Alberto0235/LLC-GaN-Microinverter/Simulations/Efficiency_Sweep/Full 100W 100KHz.asc

A1: diffschmitt; vhigh=5 vlow=0 vt={vt}; trise=10n tfall=10n
A2: diffschmitt; vhigh=5 vlow=0 vt={vt}; trise=10n tfall=10n
A3: diffschmitt; vhigh=5 vlow=0 vt={vt}; trise=10n tfall=10n
A4: diffschmitt; vhigh=5 vlow=0 vt={vt}; trise=10n tfall=10n
C1: cap; 40µ
C2: cap; 10µ; Rser=1n
Cr: cap; 3.4µ
L1: ind2; 297m
L2: ind2; 1m
L3: ind; 120µ; Rser=1n
Lm: ind; 3.93µ
LOAD: res; 565
Lr: ind; 743n
TA1: GaN_LTspice_GS-065-004-1-L_L1V3P1
TA2: GaN_LTspice_GS-065-004-1-L_L1V3P1
TB1: GaN_LTspice_GS-065-004-1-L_L1V3P1
TB2: GaN_LTspice_GS-065-004-1-L_L1V3P1
U1: EPCGaN; EPC2207
U2: EPCGaN; EPC2207
U3: EPCGaN; EPC2207
U4: EPCGaN; EPC2207
U5: GaN_LTspice_GS-065-004-1-L_L1V3P1
U6: GaN_LTspice_GS-065-004-1-L_L1V3P1
U7: GaN_LTspice_GS-065-004-1-L_L1V3P1
U8: GaN_LTspice_GS-065-004-1-L_L1V3P1
V1: voltage; 24
V2: voltage; PULSE(0 5 0 4n 4n {1/(2*f)} {1/f})
V3: voltage; PULSE(0 5 {(1/(2*f))+2*td} 4n 4n {(1/(2*f))-4*td} {1/f})
V4: voltage; PULSE(0 5 {(1/(2*f))+2*td} 4n 4n {(1/(2*f))-4*td} {1/f})
V5: voltage; PULSE(0 5 0 4n 4n {1/(2*f)} {1/f})
V6: voltage; PULSE(0 5 0 4n 4n {1/(2*f)} {1/f})
V7: voltage; PULSE(0 5 {(1/(2*f))+2*td} 4n 4n {(1/(2*f))-4*td} {1/f})
V8: voltage; PULSE(0 5 {(1/(2*f))+2*td} 4n 4n {(1/(2*f))-4*td} {1/f})
V9: voltage; PULSE(0 5 0 4n 4n {1/(2*f)} {1/f})
V10: voltage; PULSE({-v_tri} {v_tri} 0 {1/(2*f_tri)} {1/(2*f_tri)} 0 {1/f_tri})
V11: voltage; SINE(0 {V_control} {f_sin})
V12: voltage; PULSE({-v_tri} {v_tri} 0 {1/(2*f_tri)} {1/(2*f_tri)} 0 {1/f_tri})
V13: voltage; SINE(0 {V_control} {f_sin} 0 0 180)
V15: voltage; PULSE({-v_tri} {v_tri} 0 {1/(2*f_tri)} {1/(2*f_tri)} 0 {1/f_tri})
V16: voltage; SINE(0 {V_control} {f_sin})
V17: voltage; PULSE({-v_tri} {v_tri} 0 {1/(2*f_tri)} {1/(2*f_tri)} 0 {1/f_tri})
V18: voltage; SINE(0 {V_control} {f_sin} 0 0 180)
Named nets: G1, G2, G3, G4, S1, S2, S, 0, VOUT, VIN, G5, G6, G7, G8, S5, S6, VC1+, VC1-, VC2+, VC2-, VC1\+, VC2\+, VOUT2, VOUT1
K L1 L2 1
.tran 40.01m
.param f=100k td=4n
.meas Pin AVG V(VIN)*-I(V1) FROM 20m TO 40m
.meas Pout AVG V(VOUT1,VOUT2)*-I(LOAD) FROM 20m TO 40m
.meas Eff param Pout/Pin
.meas Vin AVG V(VIN) FROM 20m TO 40m
.meas Iin AVG -I(V1) FROM 20m TO 40m
.meas Vout RMS V(VOUT1,VOUT2) FROM 20m TO 40m
.meas Iout RMS I(LOAD) FROM 20m TO 40m
.lib EPCGaNLibrary.lib
.param v_control=4.201 v_tri=5 vt=0.02 f_tri=100k f_sin=50
.param Vin=325 I_in=0.31 eff=0.98
