Alberto0235/LLC-GaN-Microinverter/Simulations/Device_Comparison/Circuit 400W V1 100KHz - GAN080-650EBE_LTspice.asc

C1: cap; 10µ
Cr: cap; 3.4µ
L1: ind2; 297m
L2: ind2; 1m
Lm: ind; 3.93µ
LOAD: res; 400
Lr: ind; 743n
U1: EPCGaN; EPC2207
U2: EPCGaN; EPC2207
U3: EPCGaN; EPC2207
U4: EPCGaN; EPC2207
U5: GAN080-650EBE
U6: GAN080-650EBE
U7: GAN080-650EBE
U9: GAN080-650EBE
V1: voltage; 24
V2: voltage; PULSE(0 5 0 4n 4n {1/(2*f)} {1/f})
V3: voltage; PULSE(0 5 {(1/(2*f))+2*td} 4n 4n {(1/(2*f))-4*td} {1/f})
V4: voltage; PULSE(0 5 {(1/(2*f))+2*td} 4n 4n {(1/(2*f))-4*td} {1/f})
V5: voltage; PULSE(0 5 0 4n 4n {1/(2*f)} {1/f})
V6: voltage; PULSE(0 5 0 4n 4n {1/(2*f)} {1/f})
V7: voltage; PULSE(0 5 {(1/(2*f))+2*td} 4n 4n {(1/(2*f))-4*td} {1/f})
V8: voltage; PULSE(0 5 {(1/(2*f))+2*td} 4n 4n {(1/(2*f))-4*td} {1/f})
V9: voltage; PULSE(0 5 0 4n 4n {1/(2*f)} {1/f})
Named nets: G1, G2, G3, G4, S1, S2, S, 0, VOUT, VIN, G5, G6, G7, G8, S5, S6
K L1 L2 1
.tran 4m
.param f=100k td=4n
.meas Pin AVG V(VIN)*-I(V1) FROM 3m TO 4m
.meas Pout AVG V(VOUT)*I(LOAD) FROM 3m TO 4m
.meas Eff param Pout/Pin
.meas Vin AVG V(VIN) FROM 3m TO 4m
.meas Iin AVG -I(V1) FROM 3m TO 4m
.meas Vout AVG V(VOUT) FROM 3m TO 4m
.meas Iout AVG I(LOAD) FROM 3m TO 4m
.lib EPCGaNLibrary.lib
.lib GAN080-650EBE_LTspice.lib
