Alberto0235/LLC-GaN-Microinverter/Simulations/Inverter/Inverter 100KHz with parassites.asc

A1: diffschmitt; vhigh=5 vlow=0 vt={vt}; trise=10n tfall=10n
A2: diffschmitt; vhigh=5 vlow=0 vt={vt}; trise=10n tfall=10n
A3: diffschmitt; vhigh=5 vlow=0 vt={vt}; trise=10n tfall=10n
A4: diffschmitt; vhigh=5 vlow=0 vt={vt}; trise=10n tfall=10n
C1: cap; 10µ; Rser=2.8m Lser=17n
L1: ind; 120µ; Rser=120m
LOAD: res; 132
TA+: GaN_LTspice_GS-065-004-1-L_L1V3P1
TA-: GaN_LTspice_GS-065-004-1-L_L1V3P1
TB+: GaN_LTspice_GS-065-004-1-L_L1V3P1
TB-: GaN_LTspice_GS-065-004-1-L_L1V3P1
V1: voltage; PULSE({-v_tri} {v_tri} 0 {1/(2*f_tri)} {1/(2*f_tri)} 0 {1/f_tri})
V2: voltage; SINE(0 {V_control} {f_sin})
V3: voltage; PULSE({-v_tri} {v_tri} 0 {1/(2*f_tri)} {1/(2*f_tri)} 0 {1/f_tri})
V4: voltage; SINE(0 {V_control} {f_sin} 0 0 180)
V5: voltage; 400
V6: voltage; PULSE({-v_tri} {v_tri} 0 {1/(2*f_tri)} {1/(2*f_tri)} 0 {1/f_tri})
V7: voltage; SINE(0 {V_control} {f_sin})
V8: voltage; PULSE({-v_tri} {v_tri} 0 {1/(2*f_tri)} {1/(2*f_tri)} 0 {1/f_tri})
V9: voltage; SINE(0 {V_control} {f_sin} 0 0 180)
Named nets: 0, VC1+, VC1-, VC2+, VC2-, VC1\+, VC2\+, VOUT2, VOUT1, VIN
.tran 0 20.1m 0
.meas PIN AVG V(VIN)*(-I(V5)) FROM 1u TO 20.001m
.meas POUT AVG  V(VOUT2,VOUT1)*I(LOAD) FROM 1u TO 20.001m
.meas EFF PARAM POUT/PIN
.param v_control=4.113 v_tri=5 vt=0.02 f_tri=100k f_sin=50
.meas IOUT RMS I(LOAD) FROM 1u TO 20.001m
.meas VOUT RMS V(VOUT2,VOUT1) FROM 1u TO 20.001m
