Alberto0235/LLC-GaN-Microinverter/Simulations/LLC_Converter/Circuit 400W V1 100KHz with parassites.asc

C1: cap; 1µ; Rser=4.8m Lser=10n
C2: cap; 1.2µ; Rser=13.3m Lser=16n
C3: cap; 1.2µ; Rser=13.3m Lser=16n
C4: cap; 10µ; Rser=4.8m
L1: ind2; 610m
L2: ind2; 1m
L3: ind; 330n; Rser=100m
L4: ind; 330n; Rser=100m
L5: ind; 82n; Rser=20m
Lm: ind; 3.93µ
LOAD: res; 400
U1: EPCGaN; EPC2207
U2: EPCGaN; EPC2207
U3: EPCGaN; EPC2207
U4: EPCGaN; EPC2207
U5: GaN_LTspice_GS-065-004-1-L_L1V3P1
U6: GaN_LTspice_GS-065-004-1-L_L1V3P1
U7: GaN_LTspice_GS-065-004-1-L_L1V3P1
U8: GaN_LTspice_GS-065-004-1-L_L1V3P1
V1: voltage; 24
V2: voltage; PULSE(0 5 0 4n 4n {1/(2*f)} {1/f})
V3: voltage; PULSE(0 5 {(1/(2*f))+2*td} 4n 4n {(1/(2*f))-4*td} {1/f})
V4: voltage; PULSE(0 5 {(1/(2*f))+2*td} 4n 4n {(1/(2*f))-4*td} {1/f})
V5: voltage; PULSE(0 5 0 4n 4n {1/(2*f)} {1/f})
V6: voltage; PULSE(0 5 0 4n 4n {1/(2*f)} {1/f})
V7: voltage; PULSE(0 5 {(1/(2*f))+2*td} 4n 4n {(1/(2*f))-4*td} {1/f})
V8: voltage; PULSE(0 5 {(1/(2*f))+2*td} 4n 4n {(1/(2*f))-4*td} {1/f})
V9: voltage; PULSE(0 5 0 4n 4n {1/(2*f)} {1/f})
Named nets: G1, G2, G3, G4, S1, S2, S, 0, VOUT, VIN, G5, G6, G7, G8, S5, S6
K L1 L2 1
.tran 12.1m
.param f=100k td=4n
.meas Pin AVG V(VIN)*-I(V1) FROM 11m TO 12m
.meas Pout AVG V(VOUT)*I(LOAD) FROM 11m TO 12m
.meas Eff param Pout/Pin
.meas Vin AVG V(VIN) FROM 11m TO 12m
.meas Iin AVG -I(V1) FROM 11m TO 12m
.meas Vout AVG V(VOUT) FROM FROM 11m TO 12m
.meas Iout AVG I(LOAD) FROM FROM 11m TO 12m
.lib EPCGaNLibrary.lib
Cr
Lr
